luojinpeng339/TangNano9K-RV32I-AES-ShadowStack/build/aes128_tangnano9k_datapath.png

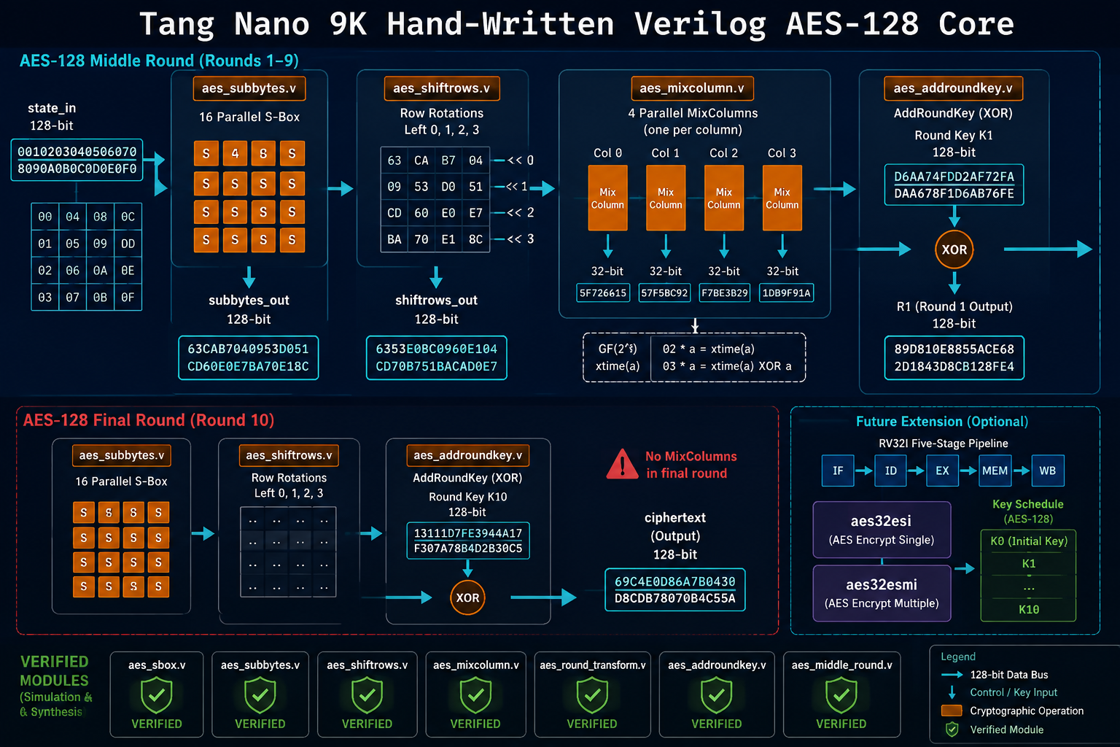
build/aes128_tangnano9k_datapath.png
