luojinpeng339/TangNano9K-RV32I-AES-ShadowStack/src/extend.v

module extend(
    input  [31:0] instr,
    input  [1:0] imm_src,
    output reg [31:0] imm_ext
);
    always @(*) begin
        case (imm_src)
            2'b00: imm_ext = {{20{instr[31]}}, instr[31:20]}; 
            2'b01: imm_ext = {{20{instr[31]}}, instr[31:25], instr[11:7]}; 
            2'b10: imm_ext = {{20{instr[31]}}, instr[7], instr[30:25], instr[11:8], 1'b0};
            2'b11: imm_ext = {{12{instr[31]}}, instr[19:12], instr[20], instr[30:21], 1'b0};
            default: imm_ext = 32'b0;
        endcase
    end
endmodule
